Fompi06/Room-Assistant/(commit log)

2026-10-25 Удалить неиспользуемые файлы и добавить лицензию MIT
    Библиотека SimpleButton нигде не подключалась и не компилировалась, 1_README.ino содержал только комментарии.
2026-10-25 Переписать скетч: модули, настройки в Config.h
    Логика разнесена по .cpp-файлам с общим заголовком RoomAssistant.h, чтобы Arduino IDE не генерировала прототипы функций раньше типов. Общий код рабочих режимов вынесен в ModeCommon, отрисовка графиков — в одну функцию. Исправлены ошибки повторных напоминаний, звука, кнопок в режиме Eco и отображения графиков.
2026-10-25 Добавить режим SIMULATION для онлайн-симуляторов
    Симуляторы часто не эмулируют прерывание сторожевого таймера, и прошивка зависала при калибровке GyverPower. При SIMULATION 1 сон заменяется обычной задержкой.
2026-10-25 Исправить удержание двух кнопок и быстрые профили
    Выход в меню проверяет состояние hold() вместо события held(), поэтому порядок нажатия кнопок не важен. После выхода программа ждёт отпускания кнопок. Профиль «обе кнопки» ждёт вторую кнопку 0,4 с. Меню перерисовывается только при изменениях.
2026-10-25 Опрашивать энкодер в прерывании
    Повороты копятся в счётчиках (Input.cpp), поэтому щелчки не теряются, пока идёт вывод на дисплей. В меню перерисовывается только строка со значением.
2026-10-25 Считать напоминание о воде по реальному времени
    Раньше напоминание зависело от суммы минут за день и срабатывало при ручной правке статистики. Отмеченный стакан теперь откладывает следующее напоминание.
2026-10-25 Укоротить подписи минут в подробном виде графиков
    Трёхзначные значения вроде «Offline:201 mins» не помещались в 16 символов.
2026-10-25 Eco: пробуждение погасшего экрана без переключения режима
    Если экран был выключен, нажатие кнопки или поворот энкодера только будят устройство.
2026-10-25 Переписать README
    Статус проекта, компоненты и подключение, установка библиотек и прошивка, настройки, использование, структура проекта.
2026-10-25 README: экраны, краткое руководство, места для фото
