Fompi06/Room-Assistant/(notices)

Notices in the files:
README.md:
License: MIT
